Tinkerforge/imu-v2-brick/software/examples/labview/Example All Data.vi.png

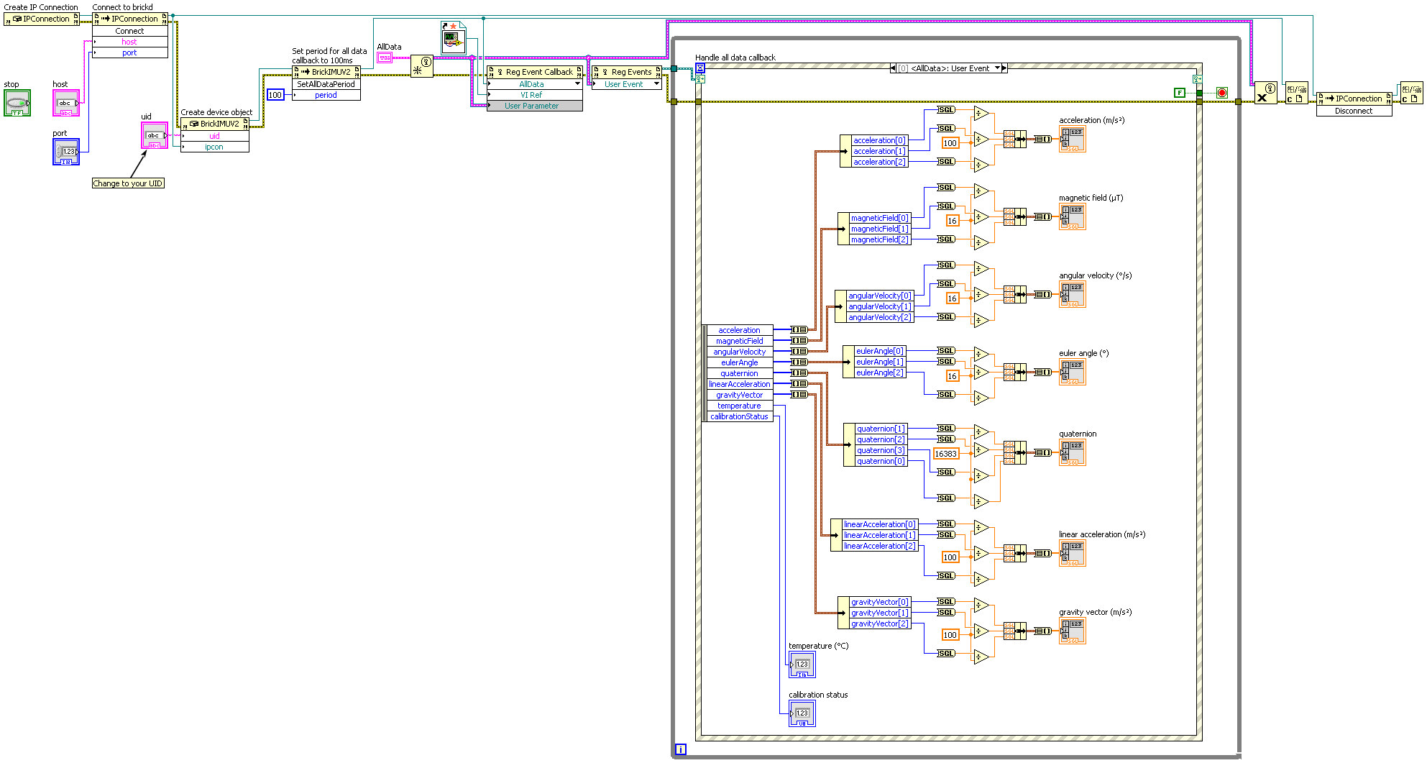
software/examples/labview/Example All Data.vi.png
