Tinkerforge/imu-v2-brick/software/examples/labview/Example Callback.vi.png

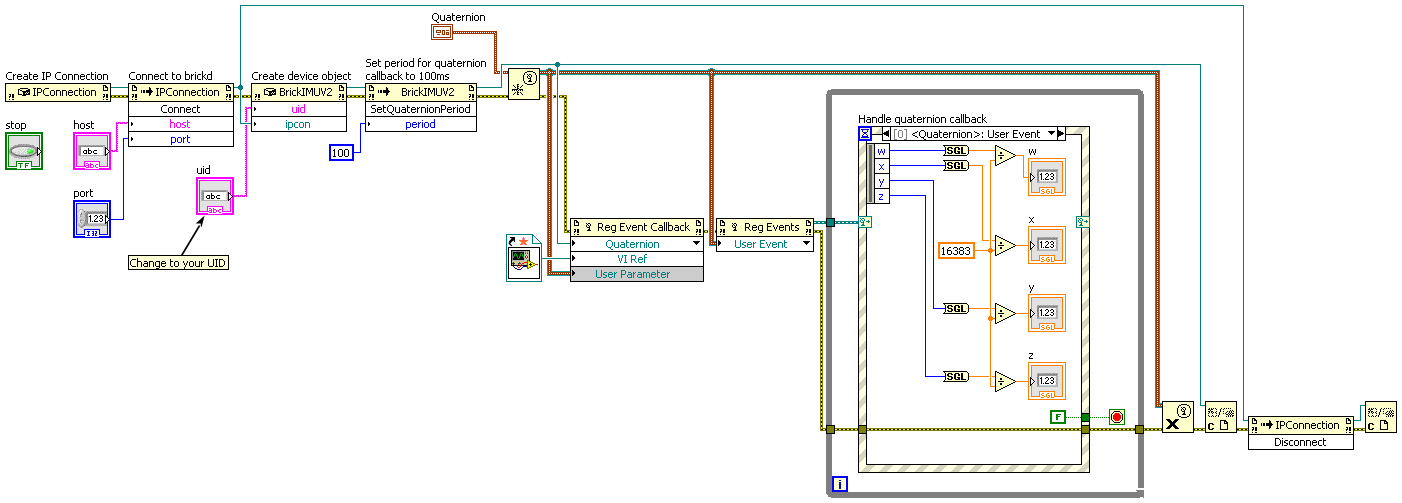
software/examples/labview/Example Callback.vi.png
