Tinkerforge/imu-v2-brick/software/examples/labview/Example Simple.vi.png

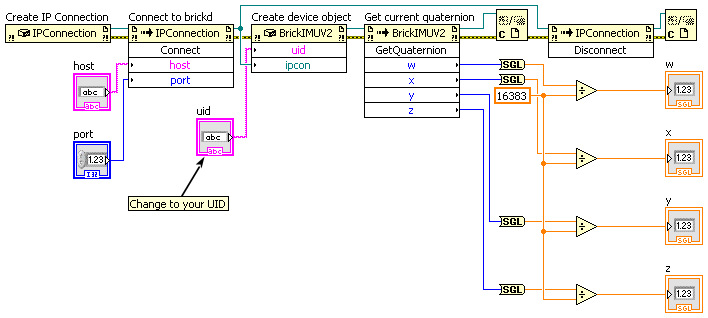
software/examples/labview/Example Simple.vi.png
