Tinkerforge/imu-v2-brick/hardware/imu.FCStd

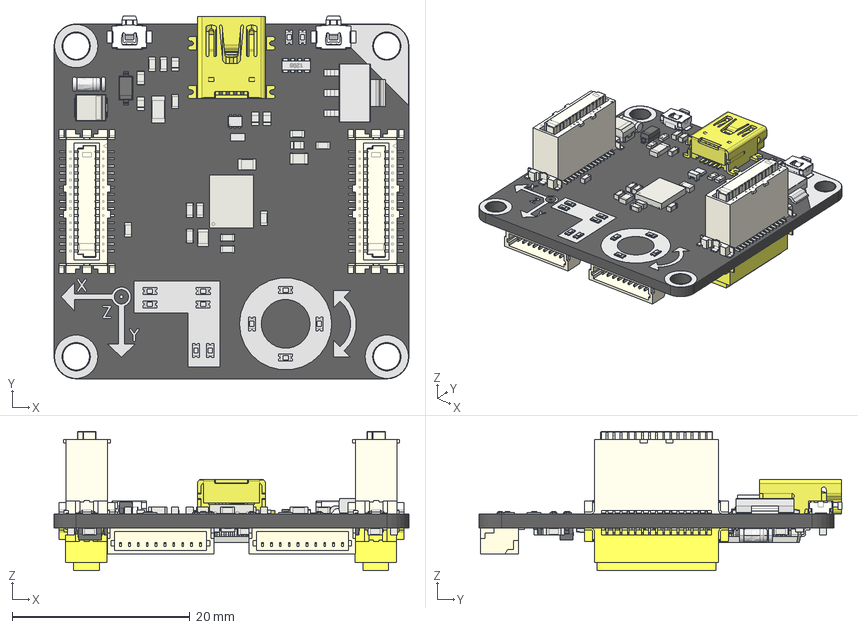
[picture p4: CAD file, 2019-05-15]
hardware/imu.FCStd
40.0 x 40.9 x 15.7 mm
Pcb
silk
USB_
Taster_
Taster_001
dfn8_6x5_p127_
R_0603_
R_0603_005
R_0603_006
R_0603_007
R_0603_008
R_0603_009
C_0805_
C_0603_
C_0603_001
C_0603_005
C_0603_006
C_0603_007
C_1206_
C_0603_013
C_0603_014
C_0805_003
C_0805_004
C_0603_027
C_0603_028
C_0603_029
C_0603_030
C_0603_033
btb_top_
btb_top_001
SOD-123_
Tantalum_B_3528H21_
WE-CNSW-0603_
SOT-563_
MiniMelf_001
SOT-223_
R_4x0603_004
D_0603_blue_
D_0603_blue_001
D_0603_blue_002
D_0603_blue_003
D_0603_blue_004
D_0603_blue_005
D_0603_blue_006
D_0603_blue_007
D_0603_blue_008
D_0603_blue_009
D_0603_red_
D_0603_blue_010
R_0603_001
R_0603_002
R_0603_003
R_0603_004
dfn10_2x3_p05_
dfn10_2x3_p05_001
C_0603_002
C_0603_003
C_0603_004
C_0603_008
C_0603_009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
