Tinkerforge/imu-v2-brick/hardware/imu-schematic.pdf

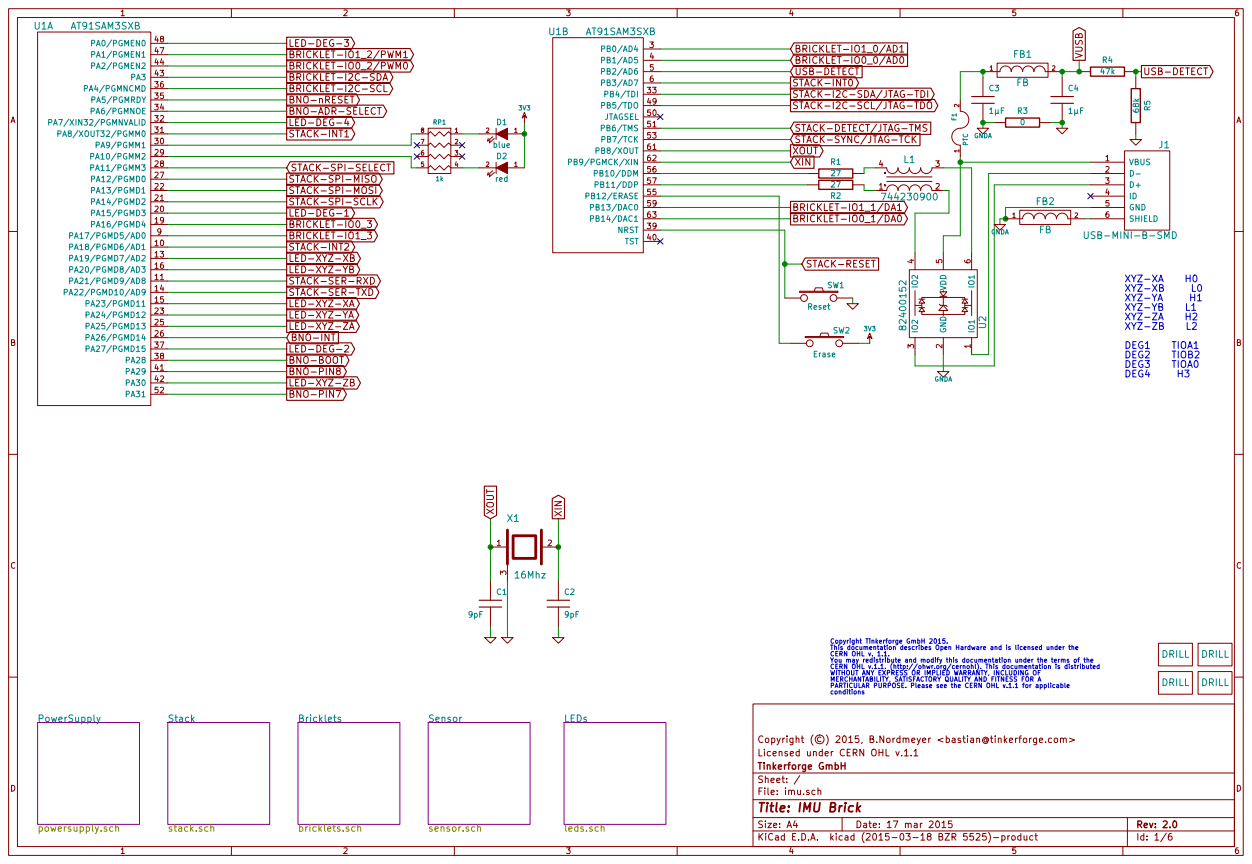
[picture p5: page 1]

BRICKLET-IO0_2/PWM0 Bricklets bricklets.sch
BRICKLET-I2C-SDA
BRICKLET-I2C-SCL
SW1 Reset SW2 Erase BNO-nRESET
3V3 BRICKLET-IO1_3
BNO-ADR-SELECT
1k LED-DEG-4
STACK-INT1

STACK-INT0
STACK-I2C-SDA/JTAG-TDI
STACK-I2C-SCL/JTAG-TDO

STACK-DETECT/JTAG-TMS
STACK-SYNC/JTAG-TCK
XOUT
XIN

Copyright Tinkerforge GmbH 2015. This documentation describes Open Hardware and is licensed under the CERN OHL v. 1.1. You may redistribute and modify this documentation under the terms of the CERN OHL v.1.1. (http://ohwr.org/cernohl). This documentation is distributed WITHOUT ANY EXPRESS OR IMPLIED WARRANTY, INCLUDING OF MERCHANTABILITY, SATISFACTORY QUALITY AND FITNESS FOR A

PARTICULAR PURPOSE. Please see the CERN OHL v.1.1 for applicable

Licensed under CERN OHL v.1.1 Copyright (©) 2015, B.Nordmeyer <bastian@tinkerforge.com>

File: imu.sch Sheet: / Tinkerforge GmbH

Id: 1/6 Title: IMU Brick

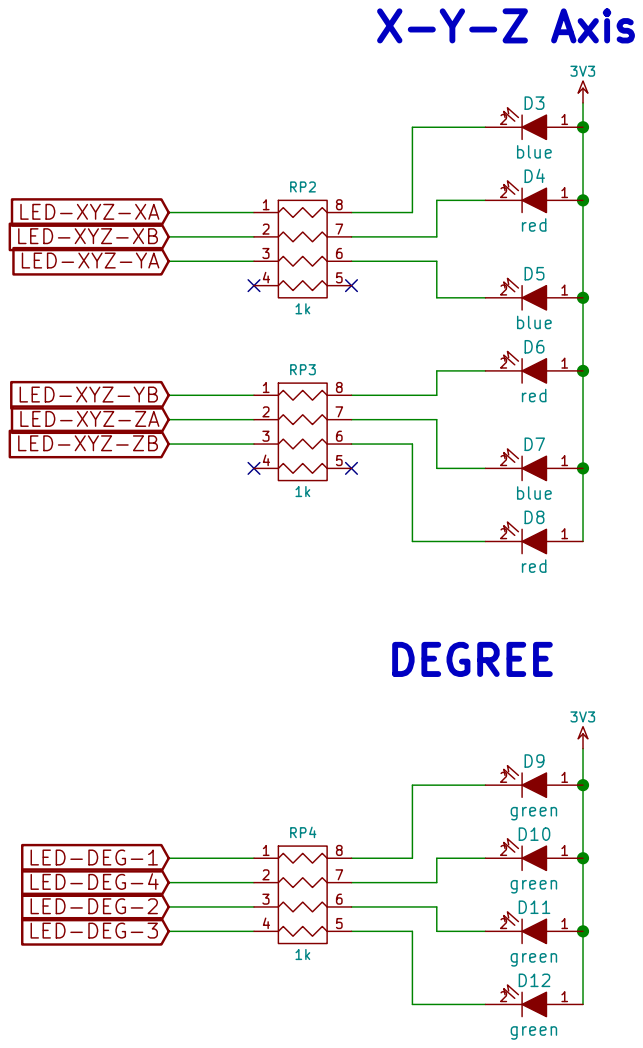
[picture p6: page 2]

Licensed under CERN OHL v.1.1 Copyright (©) 2015, B.Nordmeyer <bastian@tinkerforge.com>

File: leds.sch Sheet: /LEDs/ Tinkerforge GmbH

Id: 2/6 Title: IMU Brick

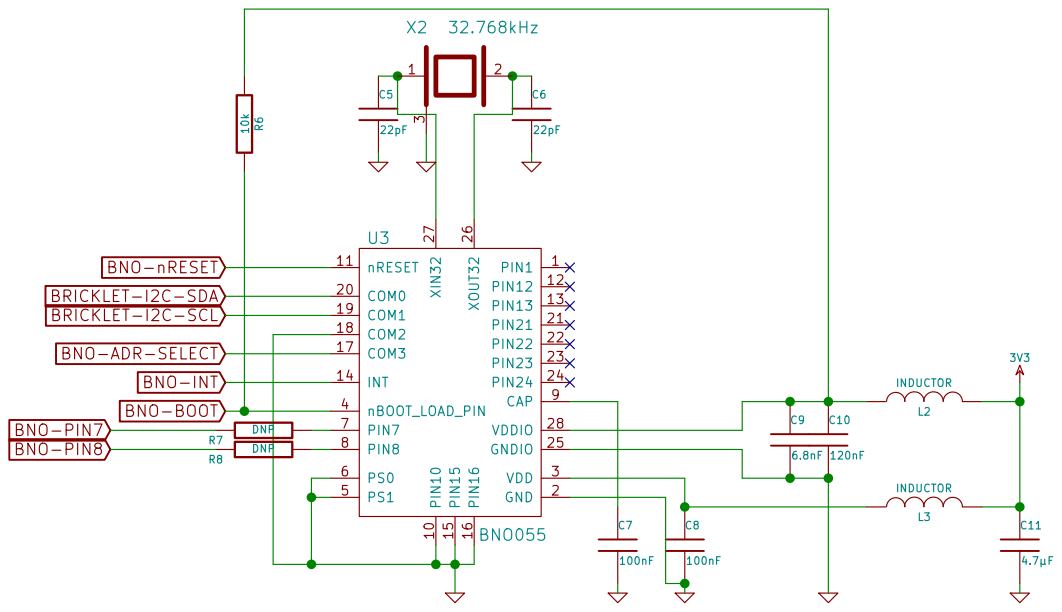
[picture p7: page 3]

Licensed under CERN OHL v.1.1 Copyright (©) 2015, B.Nordmeyer <bastian@tinkerforge.com>

File: sensor.sch Sheet: /Sensor/ Tinkerforge GmbH

Id: 3/6 Title: IMU Brick

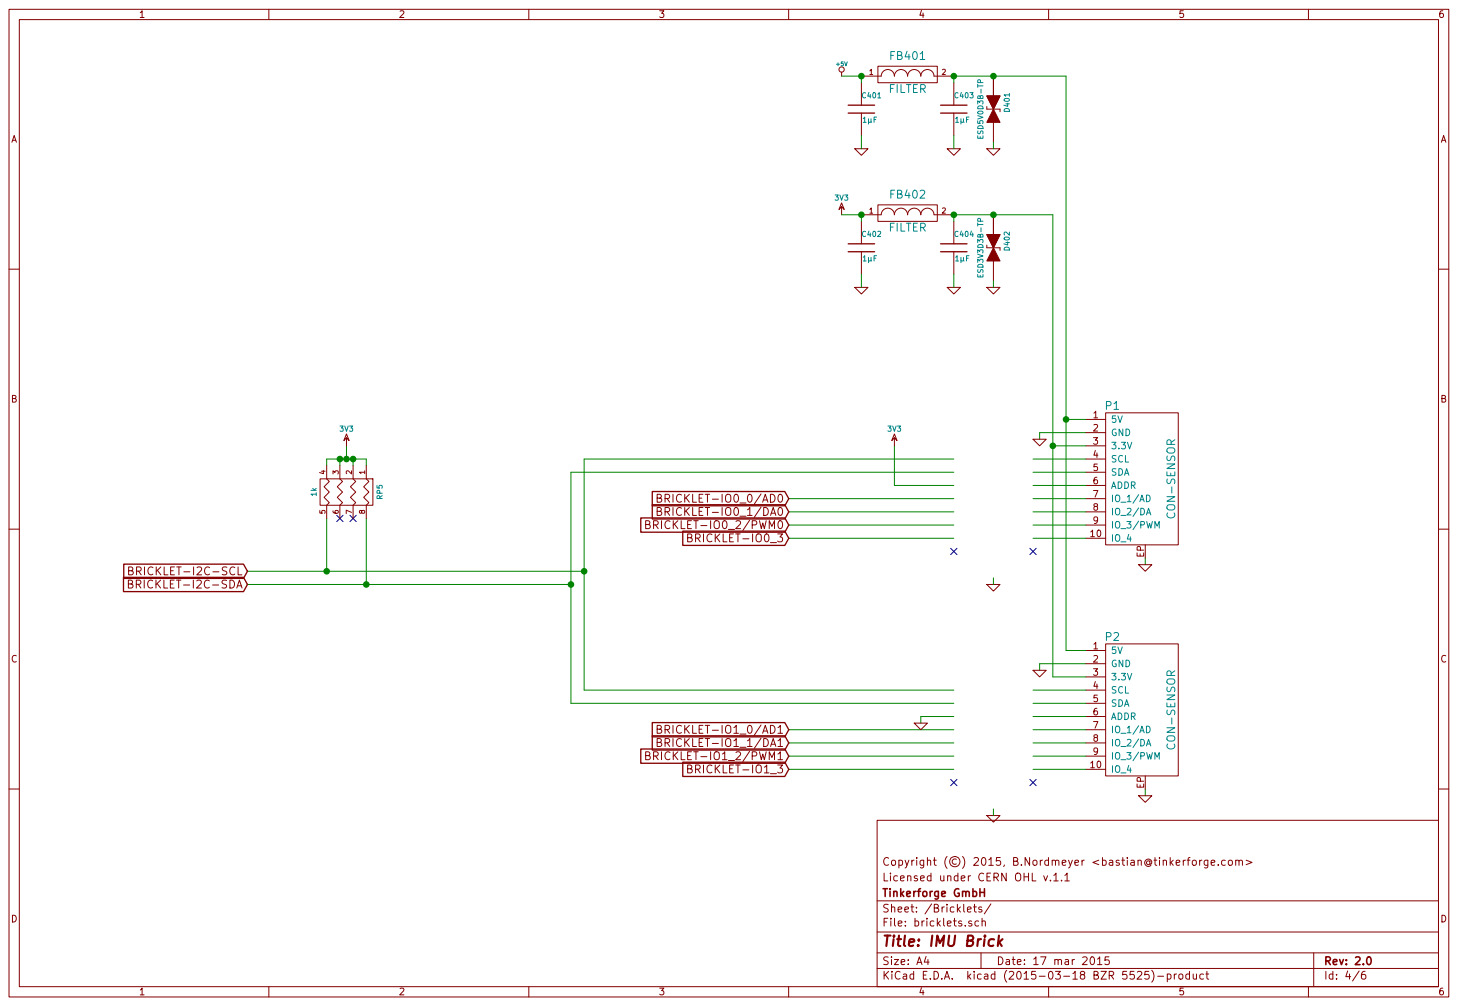
[picture p8: page 4]

IO_3/PWM 9

File: bricklets.sch Sheet: /Bricklets/ Tinkerforge GmbH

Id: 4/6 Title: IMU Brick

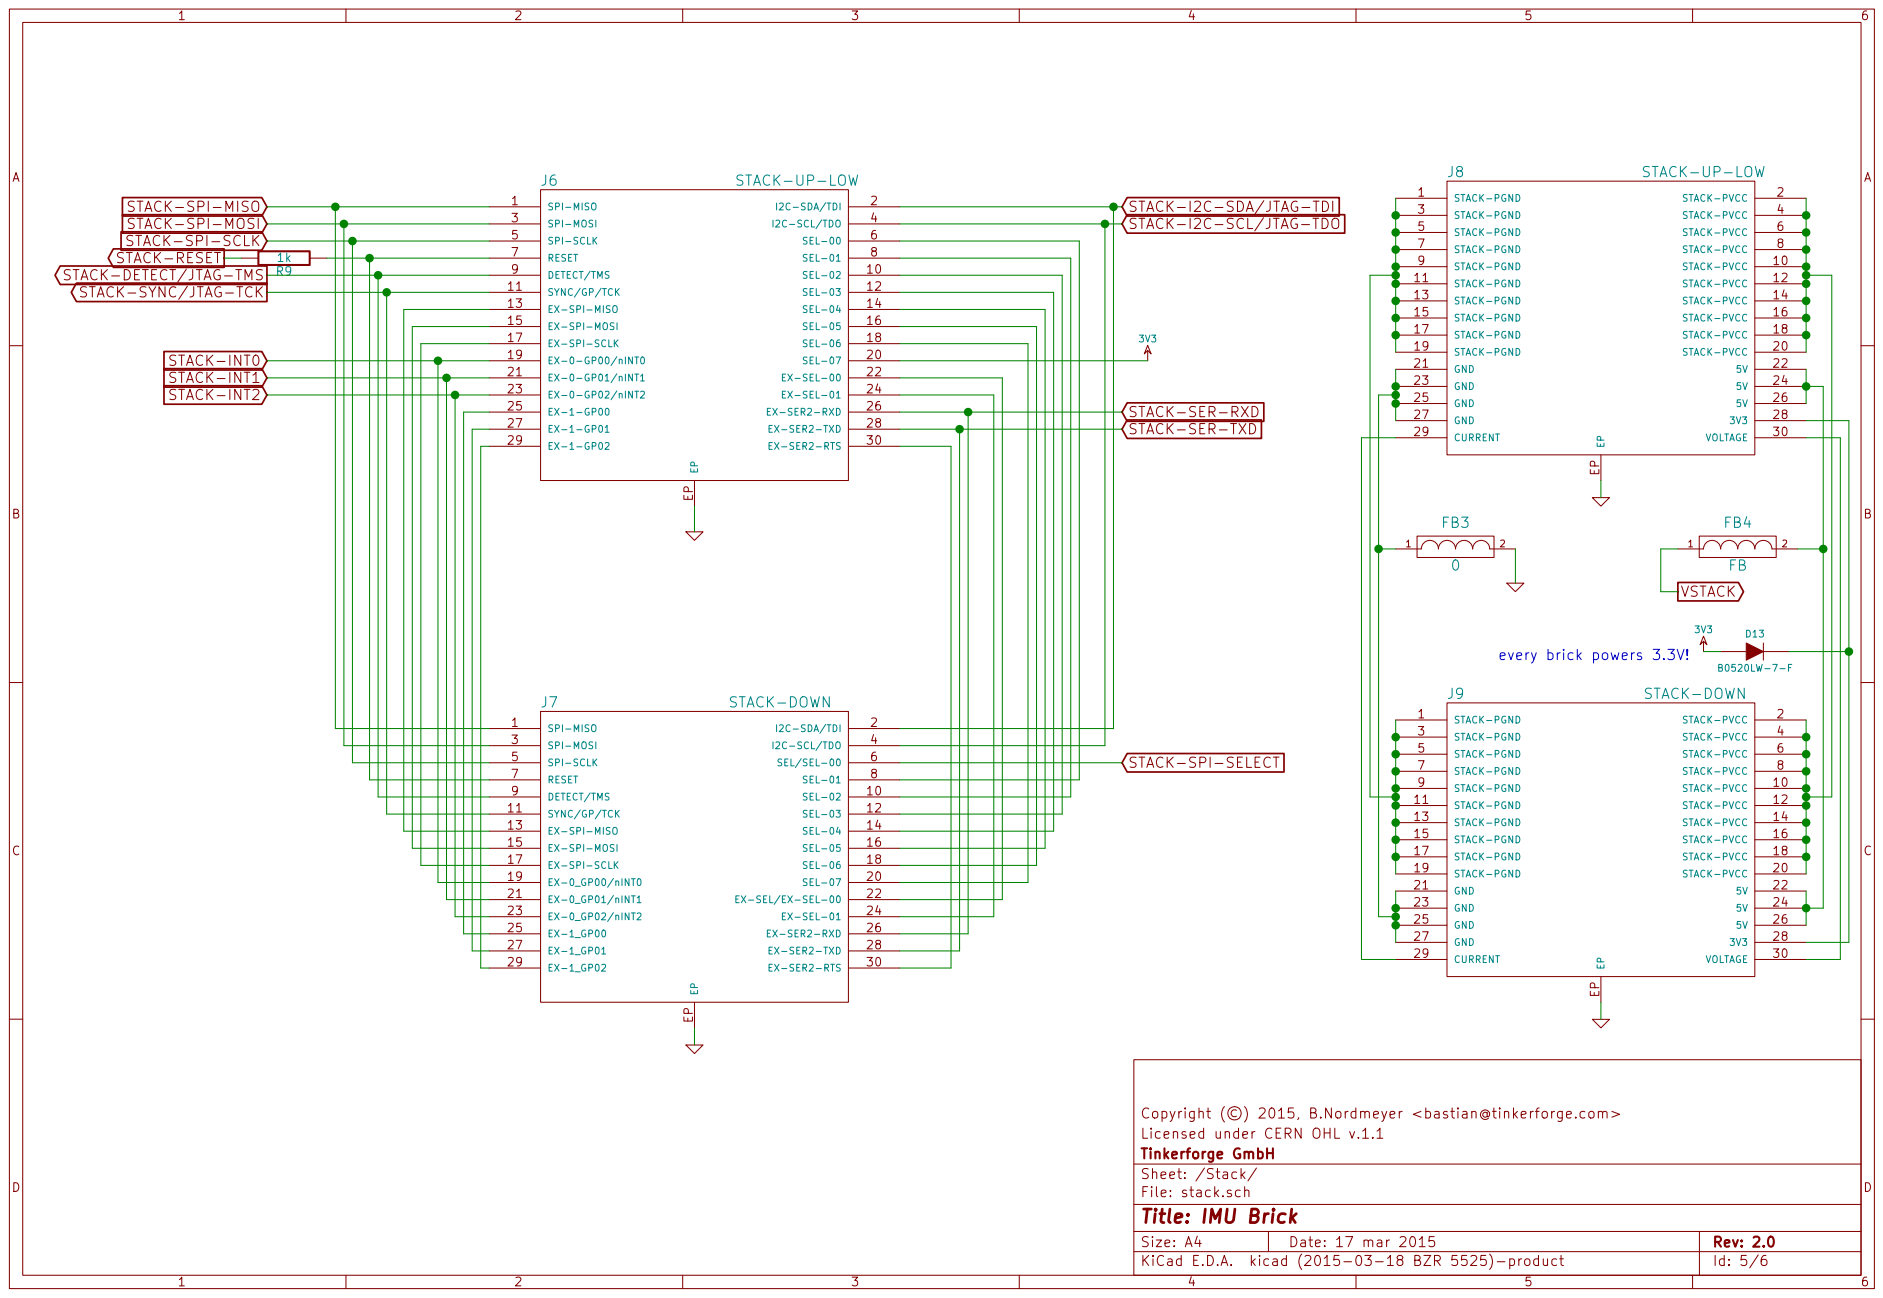
[picture p9: page 5]

STACK-SPI-MISO
STACK-SPI-MOSI
STACK-SPI-SCLK
STACK-RESET
STACK-DETECT/JTAG-TMS
STACK-SYNC/JTAG-TCK

STACK-I2C-SDA/JTAG-TDI
STACK-I2C-SCL/JTAG-TDO

Licensed under CERN OHL v.1.1 Copyright (©) 2015, B.Nordmeyer <bastian@tinkerforge.com>

File: stack.sch Sheet: /Stack/ Tinkerforge GmbH

Id: 5/6 Title: IMU Brick

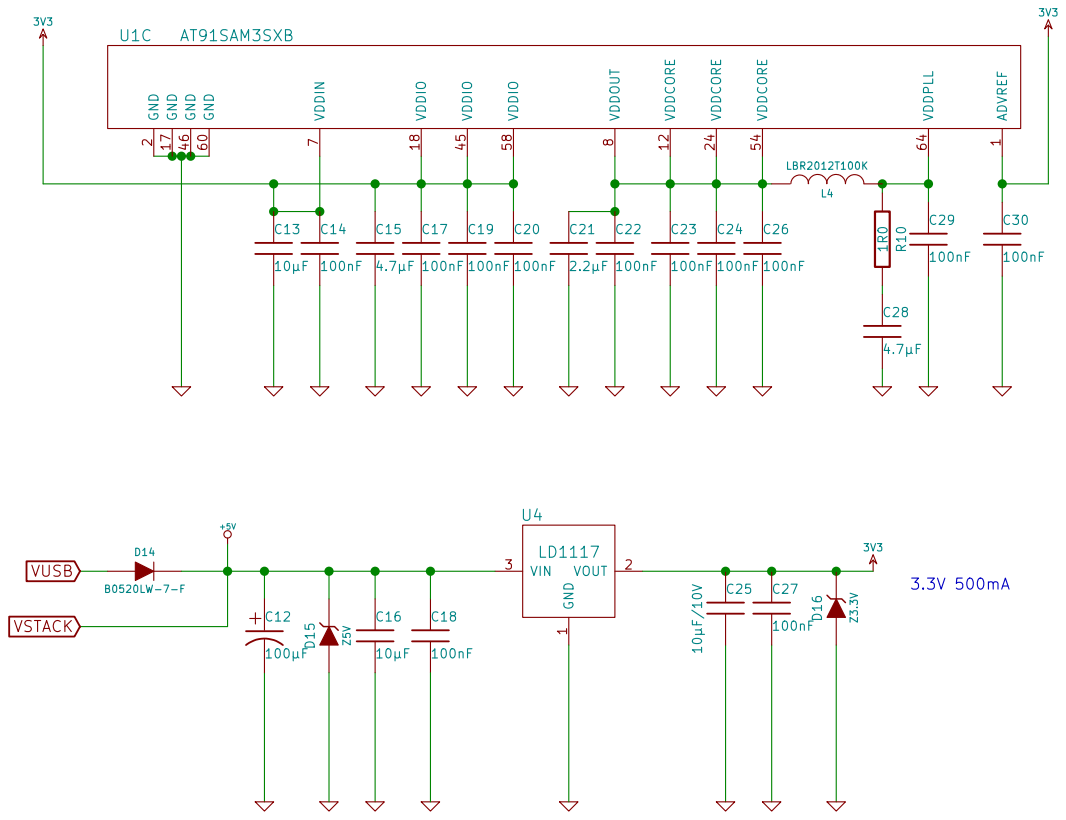
[picture p10: page 6]

8 GND 60 VDDCORE 12 VDDCORE 24 VDDCORE 54 VDDPLL 64 VDDIO 45 GND 46 GND 17 VDDIO 18 VDDIO 58

Licensed under CERN OHL v.1.1 Copyright (©) 2015, B.Nordmeyer <bastian@tinkerforge.com>

Tinkerforge GmbH
Sheet: /PowerSupply/
File: powersupply.sch
Id: 6/6 Title: IMU Brick
