Tinkerforge/imu-v2-brick/hardware/imu.kicad_pcb

## KiCad design hardware/imu.kicad_pcb (2023-05-02)

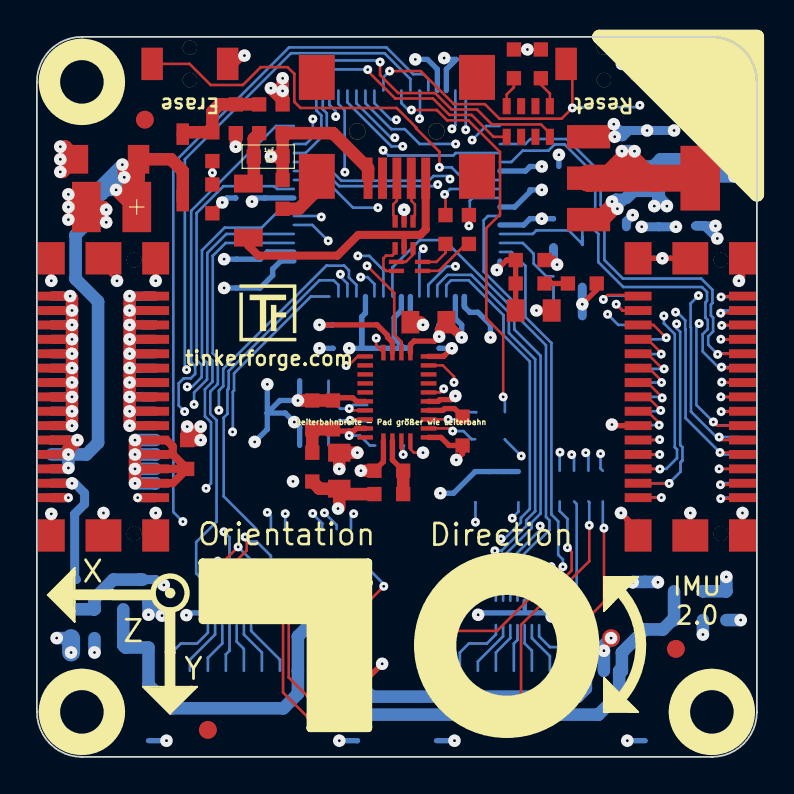
[picture p11: board imu.kicad_pcb from above]

Board: 4 copper layers, 40.0 x 40.0 mm, 107 parts (0 on the bottom side), 124 nets.

Parts:
C1, C2: DNP; C0603
C3: 1µF; 0603
C4, C401, C402, C403, C404: 1µF; C0603
C5, C6: 22pF; C0603
C7, C8, C14, C17, C18, C19, C20, C22, C23, C24, C26, C27, C29, C30: 100nF; C0603
C9: 6.8nF; C0603
C10: 120nF; C0603
C11: 4.7µF; C0805
C12: 100µF; 3528-21
C13, C16: 10µF; C0805
C15, C28: 4.7µF; C0603
C21: 2.2µF; C0603
C25: 10µF/10V; C0805
D1, D3, D5, D7: blue; D0603
D2, D4, D6, D8: red; D0603
D9, D10, D11, D12: green; D0603
D13, D14: B0520LW-7-F; SOD-123
D15: Z5V; MiniMelf
D16: Z3.3V; MiniMelf
D401: ESD5V0D3B-TP; SOD-323
D402: ESD3V3D3B-TP; SOD-323
F1: PTC; C1206
FB1, FB2, FB4: FB; C0603
FB3: 0; C0603
FB401, FB402: FILTER; C0603
FILTER401, FILTER402: IP4254; DFN16-33x135
Fiducial_Mark: VAL**; Fiducial_Mark
Fiducial_Mark#2, Fiducial_Mark#3, Fiducial_Mark#4, Fiducial_Mark#5, Fiducial_Mark#6: VAL**; Fiducial_Mark
J1: USB-MINI-B-SMD
J2, J3, J4, J5: DRILL; DRILL_NP
J6, J8: STACK-UP-LOW; BTB08-ACS-TOP
J7, J9: STACK-DOWN; BTB08-ACS-BTM
L1: 744230900; WE-CNSW-0603
L2, L3: INDUCTOR; C0603
L4: LBR2012T100K; C0805
P1, P2: CON-SENSOR
R1, R2: 27; R0603
R3: 0; R0603
R4: 47k; R0603
R5: 68k; R0603
R6: 10k; R0603
R7, R8: DNP; R0603
R9: 1k; R0603
R10: 1R0; R0603
RP1, RP2, RP3, RP4, RP5: 1k; 0603X4
SW1: Reset; TACT-SWITCH
SW2: Erase; TACT-SWITCH
U1: AT91SAM3SXB; LQFP64
U2: 82400152; SOT563-SPEC
U3: BNO055; LGA28_5832
U4: LD1117; SOT-223
VAL: CE_5mm
VAL#2: WEEE_7mm
X1: 16Mhz; CRYSTAL_3225
X2: 32.768kHz; AB26TRQ

Connections:
3V3: C11.1, C13.1, C14.1, C15.1, C17.1, C19.1, C20.1, C25.1, C27.1, C30.1, C402.1, D1.1, D2.1, D3.1, D4.1, D5.1, D6.1, D7.1, D8.1, D9.1, D10.1, D11.1, D12.1, D13.1, D16.2, FB402.1, FILTER401.14, J6.20, L2.2, L3.2, RP5.1, RP5.2, RP5.3, RP5.4, SW2.2, U1.1, U1.7, U1.18, U1.45, U1.58, U4.2
BNO-ADR-SELECT: U1.34, U3.17
BNO-BOOT: R6.2, U1.38, U3.4
BNO-INT: U1.26, U3.14
BNO-PIN7: R7.1, U1.52
BNO-PIN8: R8.1, U1.41
BNO-nRESET: U1.35, U3.11
BRICKLET-I2C-SCL: FILTER401.16, FILTER402.16, RP5.5, U1.36, U3.19
BRICKLET-I2C-SDA: FILTER401.15, FILTER402.15, RP5.8, U1.43, U3.20
BRICKLET-IO0_0/AD0: FILTER401.13, U1.4
BRICKLET-IO0_1/DA0: FILTER401.12, U1.63
BRICKLET-IO0_2/PWM0: FILTER401.11, U1.44
BRICKLET-IO0_3: FILTER401.10, U1.19
BRICKLET-IO1_0/AD1: FILTER402.13, U1.3
BRICKLET-IO1_1/DA1: FILTER402.12, U1.59
BRICKLET-IO1_2/PWM1: FILTER402.11, U1.47
BRICKLET-IO1_3: FILTER402.10, U1.9
GND: C1.2, C2.2, C4.2, C5.2, C6.2, C7.2, C8.2, C9.2, C10.2, C11.2, C12.2, C13.2, C14.2, C15.2, C16.2, C17.2, C18.2, C19.2, C20.2, C21.2, C22.2, C23.2, C24.2, C25.2, C26.2, C27.2, C28.2, C29.2, C30.2, C401.2, C402.2, C403.2, C404.2, D15.1, D16.1, D401.1, D402.1, FB3.2, FILTER401.EXP, FILTER402.14, FILTER402.EXP, J6.EP, J7.EP, J8.EP, J9.EP, P1.2, P1.EP, P2.2, P2.EP, R3.1, R5.1, SW1.2, U1.2, U1.17, U1.46, U1.60, U3.2, U3.5, U3.6, U3.10, U3.15, U3.16, U3.18, U3.25, U4.1, X1.3, X2.3
GNDA: C3.2, FB2.1, J1.5, R3.2, U2.2
LED-DEG-1: RP4.1, U1.20
LED-DEG-2: RP4.3, U1.37
LED-DEG-3: RP4.4, U1.48
LED-DEG-4: RP4.2, U1.32
LED-XYZ-XA: RP2.1, U1.15
LED-XYZ-XB: RP2.2, U1.13
LED-XYZ-YA: RP2.3, U1.23
LED-XYZ-YB: RP3.1, U1.16
LED-XYZ-ZA: RP3.2, U1.25
LED-XYZ-ZB: RP3.3, U1.42
unnamed: C3.1, F1.2, FB1.1
unnamed: C5.1, U3.27, X2.2
unnamed: C6.1, U3.26, X2.1
unnamed: C7.1, U3.9
unnamed: C8.1, L3.1, U3.3
unnamed: C9.1, C10.1, L2.1, R6.1, U3.28
unnamed: C21.1, C22.1, C23.1, C24.1, C26.1, L4.1, U1.8, U1.12, U1.24, U1.54
unnamed: C28.1, R10.1
unnamed: C29.1, L4.2, R10.2, U1.64
unnamed: C403.1, D401.2, FB401.2, P1.1, P2.1
unnamed: C404.1, D402.2, FB402.2, P1.3, P2.3
unnamed: D1.2, RP1.1
unnamed: D2.2, RP1.4
unnamed: D3.2, RP2.8
unnamed: D4.2, RP2.7
unnamed: D5.2, RP2.6
unnamed: D6.2, RP3.8
unnamed: D7.2, RP3.7
unnamed: D8.2, RP3.6
unnamed: D9.2, RP4.8
unnamed: D10.2, RP4.7
unnamed: D11.2, RP4.6
unnamed: D12.2, RP4.5
unnamed: D13.2, J8.28, J9.28
unnamed: F1.1, J1.1, U2.5
unnamed: FB2.2, J1.6
unnamed: FB3.1, J8.21, J8.23, J8.25, J8.27, J9.21, J9.23, J9.25, J9.27
unnamed: FB4.2, J8.22, J8.24, J8.26, J9.22, J9.24, J9.26
unnamed: FILTER401.1, P1.4
unnamed: FILTER401.2, P1.5
unnamed: FILTER401.3, P1.6
unnamed: FILTER401.4, P1.7
unnamed: FILTER401.5, P1.8
unnamed: FILTER401.6, P1.9
unnamed: FILTER401.7, P1.10
unnamed: FILTER402.1, P2.4
unnamed: FILTER402.2, P2.5
unnamed: FILTER402.3, P2.6
unnamed: FILTER402.4, P2.7
unnamed: FILTER402.5, P2.8
unnamed: FILTER402.6, P2.9
unnamed: FILTER402.7, P2.10
unnamed: J1.2, U2.1
unnamed: J1.3, U2.3
unnamed: J6.6, J7.8
unnamed: J6.7, J7.7, R9.1
unnamed: J6.8, J7.10
unnamed: J6.10, J7.12
unnamed: J6.12, J7.14
unnamed: J6.13, J7.13
unnamed: J6.14, J7.16
unnamed: J6.15, J7.15
unnamed: J6.16, J7.18
unnamed: J6.17, J7.17
unnamed: J6.18, J7.20
unnamed: J6.22, J7.22
unnamed: J6.24, J7.24
unnamed: J6.25, J7.25
unnamed: J6.27, J7.27
unnamed: J6.29, J7.29
unnamed: J6.30, J7.30
unnamed: J8.1, J8.3, J8.5, J8.7, J8.9, J8.11, J8.13, J8.15, J8.17, J8.19, J9.1, J9.3, J9.5, J9.7, J9.9, J9.11, J9.13, J9.15, J9.17, J9.19
unnamed: J8.2, J8.4, J8.6, J8.8, J8.10, J8.12, J8.14, J8.16, J8.18, J8.20, J9.2, J9.4, J9.6, J9.8, J9.10, J9.12, J9.14, J9.16, J9.18, J9.20
unnamed: J8.29, J9.29
unnamed: J8.30, J9.30
unnamed: L1.1, R2.1
unnamed: L1.2, U2.4
unnamed: L1.3, U2.6
unnamed: L1.4, R1.1
unnamed: R1.2, U1.56
unnamed: R2.2, U1.57
unnamed: R7.2, U3.7
unnamed: R8.2, U3.8
unnamed: RP1.5, U1.29
unnamed: RP1.8, U1.30
unnamed: SW2.1, U1.55
STACK-DETECT/JTAG-TMS: J6.9, J7.9, U1.51
STACK-I2C-SCL/JTAG-TDO: J6.4, J7.4, U1.49
STACK-I2C-SDA/JTAG-TDI: J6.2, J7.2, U1.33
STACK-INT0: J6.19, J7.19, U1.6
STACK-INT1: J6.21, J7.21, U1.31
STACK-INT2: J6.23, J7.23, U1.10
STACK-RESET: R9.2, SW1.1, U1.39
STACK-SER-RXD: J6.26, J7.26, U1.11
STACK-SER-TXD: J6.28, J7.28, U1.14
STACK-SPI-MISO: J6.1, J7.1, U1.27
STACK-SPI-MOSI: J6.3, J7.3, U1.22
STACK-SPI-SCLK: J6.5, J7.5, U1.21
STACK-SPI-SELECT: J7.6, U1.28
STACK-SYNC/JTAG-TCK: J6.11, J7.11, U1.53
USB-DETECT: R4.1, R5.2, U1.5
VSTACK: C12.1, C16.1, C18.1, C401.1, D14.2, D15.2, FB4.1, FB401.1, U4.3
VUSB: C4.1, D14.1, FB1.2, R4.2
XIN: C2.1, U1.62, X1.2
XOUT: C1.1, U1.61, X1.1
