Tinkerforge/imu-v2-brick/software/src/main.c

/* imu-v2-brick
 * Copyright (C) 2015 Olaf Lüke <olaf@tinkerforge.com>
 *
 * main.c: IMU Brick 2.0 startup code
 *
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
 * You should have received a copy of the GNU Lesser General Public
 * License along with this library; if not, write to the
 * Free Software Foundation, Inc., 59 Temple Place - Suite 330,
 * Boston, MA 02111-1307, USA.
 */

#include <stdbool.h>
#include <stdint.h>
#include <stdio.h>
#include <stdlib.h>

#include "bricklib/free_rtos/include/FreeRTOS.h"
#include "bricklib/free_rtos/include/task.h"

#include "bricklib/com/i2c/i2c_pca9549/i2c_pca9549.h"
#include "bricklib/com/spi/spi_stack/spi_stack_master.h"
#include "bricklib/com/spi/spi_stack/spi_stack_slave.h"
#include "bricklib/com/spi/spi_stack/spi_stack_common.h"
#include "bricklib/com/i2c/i2c_eeprom/i2c_eeprom_master.h"
#include "bricklib/com/i2c/i2c_eeprom/i2c_eeprom_slave.h"
#include "bricklib/com/usb/usb.h"
#include "bricklib/logging/logging.h"
#include "bricklib/bricklet/bricklet_init.h"
#include "bricklib/drivers/uid/uid.h"
#include "bricklib/drivers/wdt/wdt.h"
#include "bricklib/drivers/pio/pio.h"
#include "bricklib/utility/init.h"
#include "bricklib/utility/util_definitions.h"
#include "bricklib/utility/profiling.h"
#include "bricklib/utility/led.h"
#include "bricklib/logging/logging.h"

#include "config.h"
#include "communication.h"
#include "imu.h"

extern bool usb_first_connection;
uint8_t brick_hardware_version[3];

void vApplicationStackOverflowHook(xTaskHandle *pxTask, signed char *pcTaskName) {
	logf("Stack Overflow: %s\n\r", pcTaskName);
	led_on(LED_STD_RED);
	while(true);
}

int main() {
	imu_leds_on(false);

	const Pin pins_stack[] = {PINS_STACK};
	PIO_Configure(pins_stack, PIO_LISTSIZE(pins_stack));

	brick_hardware_version[0] = BRICK_HARDWARE_VERSION_MAJOR;
	brick_hardware_version[1] = BRICK_HARDWARE_VERSION_MINOR;
	brick_hardware_version[2] = BRICK_HARDWARE_VERSION_REVISION;

	brick_init();
	wdt_restart();

#ifdef PROFILING
    profiling_init();
#endif

    if(usb_is_connected()) {
    	logi("Configure as USB device\n\r");
    	usb_init();
    	wdt_restart();

    	xTaskCreate(usb_message_loop,
    				(signed char *)"usb_ml",
    				700,
    				NULL,
    				1,
    				(xTaskHandle *)NULL);
    } else {
    	usb_first_connection = false;
    	logi("Configure as Stack Participant (SPI)\n\r");
        spi_stack_slave_init();
        wdt_restart();

    	xTaskCreate(spi_stack_slave_message_loop,
    			    (signed char *)"spi_ml",
    			    700,
    			    NULL,
    			    1,
    			    (xTaskHandle *)NULL);
    }

	imu_init();
	wdt_restart();

	brick_init_start_tick_task();
	wdt_restart();

	vTaskStartScheduler();
}
