Tinkerforge/imu-v2-brick/software/src/imu.c

/* imu-v2-brick
 * Copyright (C) 2015 Olaf Lüke <olaf@tinkerforge.com>
 *
 * imu.c: Inertial Measurement Unit implementation
 *
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
 * You should have received a copy of the GNU Lesser General Public
 * License along with this library; if not, write to the
 * Free Software Foundation, Inc., 59 Temple Place - Suite 330,
 * Boston, MA 02111-1307, USA.
 */

#include "imu.h"

#include "config.h"
#include "communication.h"
#include "bricklib/com/com_messages.h"
#include "bricklib/com/com_common.h"
#include "bricklib/logging/logging.h"

#include "bricklib/drivers/pio/pio.h"
#include "bricklib/drivers/twi/twi.h"
#include "bricklib/drivers/twi/twid.h"
#include "bricklib/drivers/async/async.h"
#include "bricklib/drivers/pwmc/pwmc.h"
#include "bricklib/drivers/tc/tc.h"
#include "bricklib/drivers/adc/adc.h"
#include "bricklib/drivers/usb/USBD_HAL.h"
#include "bricklib/utility/util_definitions.h"
#include "bricklib/utility/init.h"
#include "bricklib/utility/led.h"
#include "bricklib/utility/sqrt.h"
#include "bricklib/utility/mutex.h"
#include "bricklib/drivers/flash/flashd.h"
#include "bricklib/drivers/efc/efc.h"

#include <stdio.h>
#include <string.h>
#include <math.h>

uint32_t imu_period[IMU_PERIOD_NUM] = {0};
uint32_t imu_period_counter[IMU_PERIOD_NUM] = {0};

bool imu_use_leds = false;
bool imu_use_orientation = true;
bool imu_mode_update = true;
bool imu_waiting_for_dma = false;
bool imu_mutex_taken = false;
uint8_t imu_waiting_for_dma_counter = 0;

Async imu_async;
extern Twid twid0;
extern Mutex mutex_twi_bricklet;

extern ComInfo com_info;

Pin pins_imu_led[] = {PINS_IMU_LED};
int8_t pins_led_tc_channel[] = {-1, -1, -1, -1, -1, -1, 1, 2, 0, -1};
int8_t pins_led_pwm_channel[] = {0, 0, 1, 1, 2, 2, -1, -1, -1, 3};
bool pins_led_is_pwm[] = {true,
                          true,
                          true,
                          true,
                          true,
                          true,
                          false,
                          false,
                          false,
                          true};

uint8_t sensor_data_tmp[sizeof(uint16_t)*4]; // Maximum size of data read in one piece is sizeof(uint16_t)*4
SensorData sensor_data = {0};
uint8_t update_sensor_counter = 0;


uint8_t imu_magnetometer_rate       = IMU_MAGNETOMETER_RATE_20HZ;
uint8_t imu_gyroscope_range         = IMU_GYROSCOPE_RANGE_2000DPS;
uint8_t imu_gyroscope_bandwidth     = IMU_GYROSCOPE_BANDWIDTH_32HZ;
uint8_t imu_accelerometer_range     = IMU_ACCELEROMETER_RANGE_4G;
uint8_t imu_accelerometer_bandwidth = IMU_ACCELEROMETER_BANDWIDTH_62_5HZ;
uint8_t imu_sensor_fusion_mode      = IMU_SENSOR_FUSION_ON;
uint8_t imu_update                  = 0;

uint32_t cal_counter = 0;

const IMUCalibrationConst *imu_calibration_in_flash = (const IMUCalibrationConst*)IMU_CALIBRATION_ADDRESS;

void tick_task(const uint8_t tick_type) {
	// Check if dma transfer ended in calculation and message task
	// If a bricklet takes the mutex in the calculation task, we can still
	// handle it here in the message task.
	// Unfortunately FreeRTOS does not allow to give the mutex back in the interrupt.
	if(!imu_waiting_for_dma && imu_mutex_taken) {
		// We give the I2C mutex back and we allow a new dma request
		mutex_give(mutex_twi_bricklet);
		imu_mutex_taken = false;

		// Copy data from last DMA transfer before we start a new one
		update_sensor_data_save();
	}

	if(tick_type == TICK_TASK_TYPE_CALCULATION) {
		update_sensor_data();

		if(update_sensor_counter == 5) {
			imu_blinkenlights();
		}

		for(uint8_t i = 0; i < IMU_PERIOD_NUM; i++) {
			if(imu_period_counter[i] < UINT32_MAX) {
				imu_period_counter[i]++;
			}
		}
	} else if(tick_type == TICK_TASK_TYPE_MESSAGE) {
		for(uint8_t i = 0; i < IMU_PERIOD_NUM; i++) {
			if((imu_period[i] != 0) &&
			   (imu_period[i] <= imu_period_counter[i])) {
				// Test if we are totally out of time (lost a whole
				// period), in this case we don't send the callback again.
				// This is needed for the wireless extensions
				if(imu_period[i]*2 <= imu_period_counter[i]) {
					imu_period_counter[i] = imu_period[i];
				}
				make_period_callback(i);
			}
		}
	}
}

void make_period_callback(const uint8_t type) {
	imu_period_counter[type] -= imu_period[type];

	switch(type) {
		case IMU_PERIOD_TYPE_ACC: {
			AccelerationCallback ac;
			com_make_default_header(&ac, com_info.uid, sizeof(AccelerationCallback), FID_ACCELERATION);
			ac.x = sensor_data.acc_x;
			ac.y = sensor_data.acc_y;
			ac.z = sensor_data.acc_z;

			send_blocking_with_timeout(&ac,
			                           sizeof(AccelerationCallback),
			                           com_info.current);
			break;
		}

		case IMU_PERIOD_TYPE_MAG: {
			MagneticFieldCallback mfc;
			com_make_default_header(&mfc, com_info.uid, sizeof(MagneticFieldCallback), FID_MAGNETIC_FIELD);
			mfc.x = sensor_data.mag_x;
			mfc.y = sensor_data.mag_y;
			mfc.z = sensor_data.mag_z;

			send_blocking_with_timeout(&mfc,
			                           sizeof(MagneticFieldCallback),
			                           com_info.current);
			break;
		}

		case IMU_PERIOD_TYPE_ANG: {
			AngularVelocityCallback avc;
			com_make_default_header(&avc, com_info.uid, sizeof(AngularVelocityCallback), FID_ANGULAR_VELOCITY);
			avc.x = sensor_data.gyr_x;
			avc.y = sensor_data.gyr_y;
			avc.z = sensor_data.gyr_z;

			send_blocking_with_timeout(&avc,
			                           sizeof(AngularVelocityCallback),
			                           com_info.current);
			break;
		}

		case IMU_PERIOD_TYPE_TMP: {
			TemperatureCallback tc;
			com_make_default_header(&tc, com_info.uid, sizeof(TemperatureCallback), FID_TEMPERATURE);
			tc.temperature = sensor_data.temperature;

			send_blocking_with_timeout(&tc,
			                           sizeof(TemperatureCallback),
			                           com_info.current);
			break;
		}

		case IMU_PERIOD_TYPE_LIA: {
			LinearAccelerationCallback lac;
			com_make_default_header(&lac, com_info.uid, sizeof(LinearAccelerationCallback), FID_LINEAR_ACCELERATION);
			lac.x = sensor_data.lia_x;
			lac.y = sensor_data.lia_y;
			lac.z = sensor_data.lia_z;

			send_blocking_with_timeout(&lac,
			                           sizeof(LinearAccelerationCallback),
			                           com_info.current);
			break;
		}

		case IMU_PERIOD_TYPE_GRV: {
			GravityVectorCallback gvc;
			com_make_default_header(&gvc, com_info.uid, sizeof(GravityVectorCallback), FID_GRAVITY_VECTOR);
			gvc.x = sensor_data.grv_x;
			gvc.y = sensor_data.grv_y;
			gvc.z = sensor_data.grv_z;

			send_blocking_with_timeout(&gvc,
			                           sizeof(GravityVectorCallback),
			                           com_info.current);
			break;
		}


		case IMU_PERIOD_TYPE_ORI: {
			OrientationCallback oc;
			com_make_default_header(&oc, com_info.uid, sizeof(OrientationCallback), FID_ORIENTATION);
			oc.roll    = sensor_data.eul_roll;
			oc.pitch   = sensor_data.eul_pitch;
			oc.heading = sensor_data.eul_heading;

			send_blocking_with_timeout(&oc,
			                           sizeof(OrientationCallback),
			                           com_info.current);
			break;
		}

		case IMU_PERIOD_TYPE_QUA: {
			QuaternionCallback qc;
			com_make_default_header(&qc, com_info.uid, sizeof(QuaternionCallback), FID_QUATERNION);
			qc.x = sensor_data.qua_x;
			qc.y = sensor_data.qua_y;
			qc.z = sensor_data.qua_z;
			qc.w = sensor_data.qua_w;

			send_blocking_with_timeout(&qc,
			                           sizeof(QuaternionCallback),
			                           com_info.current);
			break;
		}

		case IMU_PERIOD_TYPE_ALL: {
			AllDataCallback adc;
			com_make_default_header(&adc, com_info.uid, sizeof(AllDataCallback), FID_ALL_DATA);

			memcpy(&adc.acceleration, &sensor_data, sizeof(SensorData));

			send_blocking_with_timeout(&adc,
			                           sizeof(AllDataCallback),
			                           com_info.current);
			break;
		}
	}
}

/*
Python script to make the lookup table:

s = "{0"
for i in range(1, 21):
    s += ", " + str(0xffff/2 - ((1000-i**3/((20**3)/1000))*(0xFFFF/2)/1000))
for i in reversed(range(0, 20)):
    s += ", " + str(0xffff/2 + ((1000-i**3/((20**3)/1000))*(0xFFFF/2)/1000))
print s + "}"
*/
const uint16_t blink_lookup[41] = {1, 1, 33, 99, 263, 492, 885, 1377, 2098, 2982, 4096, 5440, 7078, 8979, 11240, 13795, 16777, 20119, 23888, 28082, 32767, 37452, 41646, 45415, 48757, 51739, 54294, 56555, 58456, 60094, 61438, 62552, 63436, 64157, 64649, 65042, 65271, 65435, 65501, 65534, 65534};

void imu_leds_on(const bool on) {
	if(on) {
		PMC->PMC_PCER0 = 1 << ID_PWM;
		for(uint8_t i = 0; i < 4; i++) {
			PWMC_ConfigureChannel(PWM, i, PWM_CMR_CPRE_MCK, 0, 0);
			PWMC_SetPeriod(PWM, i, 0xFFFF);
			PWMC_SetDutyCycle(PWM, i, 0);
			PWMC_EnableChannel(PWM, i);
		}

	    PMC->PMC_PCER0 = 1 << ID_TC0;
	    tc_channel_init(&TC0->TC_CHANNEL[0],
		                TC_CMR_WAVE |
		                TC_CMR_TCCLKS_TIMER_CLOCK1 |
		                TC_CMR_ACPA_CLEAR |
		                TC_CMR_ACPC_SET |
		                TC_CMR_WAVSEL_UP_RC);

	    TC0->TC_CHANNEL[0].TC_RA = 0;
	    TC0->TC_CHANNEL[0].TC_RC = 0xFFFF;
	    tc_channel_start(&TC0->TC_CHANNEL[0]);

	    PMC->PMC_PCER0 = 1 << ID_TC1;
		tc_channel_init(&TC0->TC_CHANNEL[1],
		                TC_CMR_WAVE |
		                TC_CMR_TCCLKS_TIMER_CLOCK1 |
		                TC_CMR_ACPA_CLEAR |
		                TC_CMR_ACPC_SET |
		                TC_CMR_WAVSEL_UP_RC);

	    TC0->TC_CHANNEL[1].TC_RA = 0;
	    TC0->TC_CHANNEL[1].TC_RC = 0xFFFF;
	    tc_channel_start(&TC0->TC_CHANNEL[1]);

	    PMC->PMC_PCER0 = 1 << ID_TC2;
		tc_channel_init(&TC0->TC_CHANNEL[2],
		                TC_CMR_WAVE |
		                TC_CMR_TCCLKS_TIMER_CLOCK1 |
		                TC_CMR_BCPB_CLEAR |
		                TC_CMR_BCPC_SET |
		                TC_CMR_EEVT_XC0 |
		                TC_CMR_WAVSEL_UP_RC);

	    TC0->TC_CHANNEL[2].TC_RB = 0;
	    TC0->TC_CHANNEL[2].TC_RC = 0xFFFF;
	    tc_channel_start(&TC0->TC_CHANNEL[2]);


		PIO_Configure(pins_imu_led, PIO_LISTSIZE(pins_imu_led));
	} else {
		PMC->PMC_PCER0 &= ~(1 << ID_PWM);
		PMC->PMC_PCER0 &= ~(1 << ID_TC0);
		PMC->PMC_PCER0 &= ~(1 << ID_TC1);
		PMC->PMC_PCER0 &= ~(1 << ID_TC2);

		Pin pins[] = {PINS_IMU_LED};
		for(uint8_t i = 0; i < PIO_LISTSIZE(pins); i++) {
			pins[i].type = PIO_OUTPUT_1;
		}

		PIO_Configure(pins, PIO_LISTSIZE(pins));
	}

	imu_use_leds = on;
}

void imu_blinkenlights(void) {
	if(!imu_use_leds) {
		return;
	}

	PWMC_SetDutyCycle(PWM, 0,
	                  blink_lookup[(BETWEEN(-1000, sensor_data.acc_x, 1000) +
	                                1000)/50]);
	PWMC_SetDutyCycle(PWM, 1,
	                  blink_lookup[(BETWEEN(-1000, sensor_data.acc_y, 1000) +
	                                1000)/50]);
	PWMC_SetDutyCycle(PWM, 2,
	                  blink_lookup[40 - (BETWEEN(-1000, sensor_data.acc_z, 1000) +
	                               1000)/50]);

	int16_t degree = sensor_data.eul_heading/16;
	if(degree < 0) {
		degree += 360;
	}

	if(degree < 90) {
		uint8_t index = degree * 40 / 90;
		TC0->TC_CHANNEL[0].TC_RA = blink_lookup[40-index];;
		TC0->TC_CHANNEL[1].TC_RA = 0;
		TC0->TC_CHANNEL[2].TC_RB = 0;
		PWMC_SetDutyCycle(PWM, 3, blink_lookup[40-index]);
	} else if(degree < 180) {
		uint8_t index = (degree - 90) * 40 / 90;
		TC0->TC_CHANNEL[0].TC_RA = blink_lookup[index];
		TC0->TC_CHANNEL[1].TC_RA = blink_lookup[40-index];
		TC0->TC_CHANNEL[2].TC_RB = 0;
		PWMC_SetDutyCycle(PWM, 3, 0);
	} else if(degree < 270) {
		uint8_t index = (degree - 180) * 40 / 90;
		TC0->TC_CHANNEL[0].TC_RA = 0;
		TC0->TC_CHANNEL[1].TC_RA = blink_lookup[index];
		TC0->TC_CHANNEL[2].TC_RB = blink_lookup[40-index];
		PWMC_SetDutyCycle(PWM, 3, 0);
	} else {
		uint8_t index = (degree - 270) * 40 / 90;
		TC0->TC_CHANNEL[0].TC_RA = 0;
		TC0->TC_CHANNEL[1].TC_RA = 0;
		TC0->TC_CHANNEL[2].TC_RB = blink_lookup[index];
		PWMC_SetDutyCycle(PWM, 3, blink_lookup[index]);
	}
}

void update_sensor_data_save(void) {
	// We disable irq during copying of data, otherwise we may get an interrupt
	// right in the middle of the memcpy and the data is corrupted
	__disable_irq();
	switch(update_sensor_counter) {
		case 0:
			memcpy((uint8_t*)&sensor_data.acc_x, sensor_data_tmp, sizeof(int16_t)*3);
			break;
		case 1:
			memcpy((uint8_t*)&sensor_data.mag_x, sensor_data_tmp, sizeof(int16_t)*3);
			break;
		case 2:
			memcpy((uint8_t*)&sensor_data.gyr_x, sensor_data_tmp, sizeof(int16_t)*3);
			break;
		case 3:
			memcpy((uint8_t*)&sensor_data.eul_heading, sensor_data_tmp, sizeof(int16_t)*3);
			break;
		case 4:
			memcpy((uint8_t*)&sensor_data.qua_w, sensor_data_tmp, sizeof(uint16_t)*4);
			break;
		case 5:
			memcpy((uint8_t*)&sensor_data.lia_x, sensor_data_tmp, sizeof(int16_t)*3);
			break;
		case 6:
			memcpy((uint8_t*)&sensor_data.grv_x, sensor_data_tmp, sizeof(int16_t)*3);
			break;
		case 7:
			memcpy((uint8_t*)&sensor_data.temperature, sensor_data_tmp, sizeof(int8_t)*1);
			break;
		case 8:
			memcpy((uint8_t*)&sensor_data.calibration_status, sensor_data_tmp, sizeof(uint8_t)*1);
			break;
		default: // should always be in case of 9
			break;
	}
	__enable_irq();

	update_sensor_counter++;
	switch(imu_sensor_fusion_mode) {
		case IMU_SENSOR_FUSION_OFF: {
			if(update_sensor_counter == 3) {
				update_sensor_counter = 7; // Read temperature after acc, mag and gyr data
			} else if(update_sensor_counter > 3) {
				update_sensor_counter = 0; // Go back to beginning after reading temperature
			}

			break;
		}

		case IMU_SENSOR_FUSION_ON_WO_FST_MAG_CAL: // fall-through
		case IMU_SENSOR_FUSION_ON: {
			if(update_sensor_counter == 9) {
				update_sensor_counter = 0;
			}

			break;
		}

		case IMU_SENSOR_FUSION_ON_WO_MAG: {
			if(update_sensor_counter == 1) {
				update_sensor_counter = 2;
			}
			if(update_sensor_counter == 9) {
				update_sensor_counter = 0;
			}

			break;
		}
	}
}

void update_sensor_data_callback(Async *a) {
	// We give the I2C mutex back and we allow a new dma request
	imu_waiting_for_dma = false;
}

void update_sensor_data(void) {
	if(imu_waiting_for_dma) {
		// The communication should only take approximately 0.5ms, if it takes
		// much longer we have to assume that for some reason the DMA callback
		// did not come.
		imu_waiting_for_dma_counter++;
		if(imu_waiting_for_dma_counter > 15) {
			twid0.pTransfer = NULL;
			imu_waiting_for_dma_counter = 0;
			imu_waiting_for_dma = false;
			imu_mutex_taken = false;
			if(imu_mutex_taken) {
				mutex_give(mutex_twi_bricklet);
			}
		}
		return;
	}

	// Don't try to update configuration if mutex is taken
	if(imu_mutex_taken) {
		return;
	}

	// First we take a look for configuration updates
	if(imu_update != 0) {
		if(imu_update & IMU_UPDATE_SENSOR_CONFIGURATION) {
			imu_update_sensor_configuration();
			imu_update &= ~IMU_UPDATE_SENSOR_CONFIGURATION;
		} else if(imu_update & IMU_UPDATE_SENSOR_FUSION_MODE) {
			imu_update_sensor_fusion_mode();
			imu_update &= ~IMU_UPDATE_SENSOR_FUSION_MODE;
		} else if(imu_update & IMU_UPDATE_SENSOR_CALIBRATION) {
			read_calibration_from_bno055_and_save_to_flash();
			imu_update &= ~IMU_UPDATE_SENSOR_CALIBRATION;
		} else {
			// Unknown update!
			// We delete it to not end up in an endless loop
			imu_update = 0;
		}

		return;
	}

	// Make sure that we can't start two DMA requests at a time
	imu_waiting_for_dma = true;
	imu_waiting_for_dma_counter = 0;

	// Unfortunately there does not seem to be a way to
	// get an interrupt from the BMO055 if new data is ready

	// Since the BMO055 has an update rate of 100Hz we just
	// Read the data every 10ms. This unfortunately means that
	// we may get a maximum delay of 10ms before the user
	// gets the data. MEH.
	switch(update_sensor_counter) {
		case 0:
			bmo_read_registers_dma(REG_ACC_DATA_X_LSB, sensor_data_tmp, sizeof(int16_t)*3, update_sensor_data_callback);
			break;
		case 1:
			bmo_read_registers_dma(REG_MAG_DATA_X_LSB, sensor_data_tmp, sizeof(int16_t)*3, update_sensor_data_callback);
			break;
		case 2:
			bmo_read_registers_dma(REG_GYR_DATA_X_LSB, sensor_data_tmp, sizeof(int16_t)*3, update_sensor_data_callback);
			break;
		case 3:
			bmo_read_registers_dma(REG_EUL_HEADING_LSB, sensor_data_tmp, sizeof(int16_t)*3, update_sensor_data_callback);
			break;
		case 4:
			bmo_read_registers_dma(REG_QUA_DATA_W_LSB, sensor_data_tmp, sizeof(uint16_t)*4, update_sensor_data_callback);
			break;
		case 5:
			bmo_read_registers_dma(REG_LIA_DATA_X_LSB, sensor_data_tmp, sizeof(int16_t)*3, update_sensor_data_callback);
			break;
		case 6:
			bmo_read_registers_dma(REG_GRV_DATA_X_LSB, sensor_data_tmp, sizeof(int16_t)*3, update_sensor_data_callback);
			break;
		case 7:
			bmo_read_registers_dma(REG_TEMP, sensor_data_tmp, sizeof(int8_t)*1, update_sensor_data_callback);
			break;
		case 8:
			bmo_read_registers_dma(REG_CALIB_STAT, sensor_data_tmp, sizeof(uint8_t)*1, update_sensor_data_callback);
			break;
		default: // should always be in case of 9
			return;
	}
}

void bmo_write_register(const uint8_t reg, uint8_t const value) {
	mutex_take(mutex_twi_bricklet, MUTEX_BLOCKING);
	TWID_Write(&twid0,
	           BMO055_ADDRESS_HIGH,
	           reg,
	           1,
	           (uint8_t *)&value,
	           1,
	           NULL);
	mutex_give(mutex_twi_bricklet);
}

void bmo_write_registers(const uint8_t reg, const uint8_t *data, const uint8_t length) {
	mutex_take(mutex_twi_bricklet, MUTEX_BLOCKING);
    TWID_Write(&twid0,
    		   BMO055_ADDRESS_HIGH,
    		   reg,
               1,
               (uint8_t *)data,
               length,
               NULL);
	mutex_give(mutex_twi_bricklet);
}

void bmo_read_registers(const uint8_t reg, uint8_t *data, const uint8_t length) {
	mutex_take(mutex_twi_bricklet, MUTEX_BLOCKING);
    TWID_Read(&twid0,
    		  BMO055_ADDRESS_HIGH,
    		  reg,
              1,
              data,
              length,
              NULL);
	mutex_give(mutex_twi_bricklet);
}

void bmo_read_registers_dma(const uint8_t reg, uint8_t *data, const uint8_t length, void *callback) {
	imu_mutex_taken = true;
	mutex_take(mutex_twi_bricklet, MUTEX_BLOCKING);
	imu_async.callback = callback;

	TWID_Read(&twid0,
	          BMO055_ADDRESS_HIGH,
	          reg,
	          1,
	          data,
	          length,
	          &imu_async);
}

bool read_calibration_from_bno055_and_save_to_flash(void) {
	if(sensor_data.calibration_status != 0xFF) {
		return false;
	}

	bmo_write_register(REG_OPR_MODE, 0b00000000); // Configuration Mode
	SLEEP_MS(19);
	IMUCalibration imu_calibration = {{0}};
	bmo_read_registers(REG_ACC_OFFSET_X_LSB, (uint8_t *)&imu_calibration, IMU_CALIBRATION_LENGTH);
	imu_calibration.password = IMU_CALIBRATION_PASSWORD;
	bmo_write_register(REG_OPR_MODE, 0b00001100); // Enable NDOF, see Table 3-5
	SLEEP_MS(7);

	logimui("Read calibration from BNO055 and save to flash:\n\r");
	logimui(" Mag Offset: %d %d %d\n\r", imu_calibration.mag_offset[0], imu_calibration.mag_offset[1], imu_calibration.mag_offset[2]);
	logimui(" Acc Offset: %d %d %d\n\r", imu_calibration.acc_offset[0], imu_calibration.acc_offset[1], imu_calibration.acc_offset[2]);
	logimui(" Gyr Offset: %d %d %d\n\r", imu_calibration.gyr_offset[0], imu_calibration.gyr_offset[1], imu_calibration.gyr_offset[2]);
	logimui(" Acc Radius: %d\n\r", imu_calibration.acc_radius);
	logimui(" Mag Radius: %d\n\r", imu_calibration.mag_radius);

	DISABLE_RESET_BUTTON();
	__disable_irq();

	// Only change wait states on SAM4, because this makes a SAM3 hang for unknown reasons
	if(!IS_SAM3()) {
		EFC_SetWaitState(EFC, 6);
	}

	// Unlock flash region
	if(FLASHD_Unlock(IMU_CALIBRATION_ADDRESS,
	                 END_OF_BRICKLET_MEMORY,
	                 NULL,
	                 NULL) != 0) {
		return false;
	}

	// On SAM4 we have to erase the flash here, the EFC_FCMD_EWP command does not work...
	if(!IS_SAM3()) {
		// EFC_FCMD_EPA = 0x07
		EFC_PerformCommand(EFC, 0x07, (((256-32)/16) << 4) | 2, 0);
	}

	if(FLASHD_Write(IMU_CALIBRATION_ADDRESS,
	                &imu_calibration,
	                sizeof(IMUCalibration)) != 0) {
		return false;
	}

	if(FLASHD_Lock(IMU_CALIBRATION_ADDRESS,
	               END_OF_BRICKLET_MEMORY,
	               NULL,
			       NULL) != 0) {
		return false;
	}

	if(!IS_SAM3()) {
		EFC_SetWaitState(EFC, 2);
	}

	__enable_irq();
    ENABLE_RESET_BUTTON();

	return true;
}

bool read_calibration_from_flash_and_save_to_bno055(void) {
	bool ret = false;
	if(imu_calibration_in_flash->password == IMU_CALIBRATION_PASSWORD) {
		logimui("Read calibration from flash and save to BNO055:\n\r");
		logimui(" Mag Offset: %d %d %d\n\r", imu_calibration_in_flash->mag_offset[0], imu_calibration_in_flash->mag_offset[1], imu_calibration_in_flash->mag_offset[2]);
		logimui(" Acc Offset: %d %d %d\n\r", imu_calibration_in_flash->acc_offset[0], imu_calibration_in_flash->acc_offset[1], imu_calibration_in_flash->acc_offset[2]);
		logimui(" Gyr Offset: %d %d %d\n\r", imu_calibration_in_flash->gyr_offset[0], imu_calibration_in_flash->gyr_offset[1], imu_calibration_in_flash->gyr_offset[2]);
		logimui(" Acc Radius: %d\n\r", imu_calibration_in_flash->acc_radius);
		logimui(" Mag Radius: %d\n\r", imu_calibration_in_flash->mag_radius);
		ret = true;
		bmo_write_registers(REG_ACC_OFFSET_X_LSB, (uint8_t *)IMU_CALIBRATION_ADDRESS, IMU_CALIBRATION_LENGTH);
	} else {
		logimui("No calibration found\n\r");
	}

	bmo_write_register(REG_OPR_MODE, 0b00001100); // Enable NDOF, see Table 3-5
	SLEEP_MS(7);

	return ret;
}

void imu_startblink(void) {
	imu_leds_on(true);
	Pin pins[] = {PINS_IMU_LED};
	for(uint8_t i = 0; i < 6; i++) {
		pins[i].type = PIO_OUTPUT_1;
	}

	PIO_Configure(pins, PIO_LISTSIZE(pins));

	for(uint8_t i = 0; i < 41; i++) {
		TC0->TC_CHANNEL[0].TC_RA = blink_lookup[i];
		TC0->TC_CHANNEL[1].TC_RA = blink_lookup[i];
		TC0->TC_CHANNEL[2].TC_RB = blink_lookup[i];
		PWMC_SetDutyCycle(PWM, 3, blink_lookup[40-i]);
		SLEEP_MS(6);
	}
	for(uint8_t i = 0; i < 41; i++) {
		TC0->TC_CHANNEL[0].TC_RA = blink_lookup[40-i];
		TC0->TC_CHANNEL[1].TC_RA = blink_lookup[40-i];
		TC0->TC_CHANNEL[2].TC_RB = blink_lookup[40-i];
		PWMC_SetDutyCycle(PWM, 3, blink_lookup[i]);
		SLEEP_MS(6);
	}
	for(uint8_t i = 0; i < 41; i++) {
		TC0->TC_CHANNEL[0].TC_RA = blink_lookup[i];
		TC0->TC_CHANNEL[1].TC_RA = blink_lookup[i];
		TC0->TC_CHANNEL[2].TC_RB = blink_lookup[i];
		PWMC_SetDutyCycle(PWM, 3, blink_lookup[40-i]);
		SLEEP_MS(6);
	}

	imu_leds_on(false);
}

void imu_update_sensor_fusion_mode(void) {
	// First we go to config mode
	bmo_write_register(REG_OPR_MODE, 0b000);
	SLEEP_MS(19);

	// If sensor fusion is turned off, we zero all of the now non-updated data
	switch(imu_sensor_fusion_mode) {
		case IMU_SENSOR_FUSION_OFF: {
			sensor_data.eul_heading        = 0;
			sensor_data.eul_roll           = 0;
			sensor_data.eul_pitch          = 0;
			sensor_data.qua_w              = 0;
			sensor_data.qua_x              = 0;
			sensor_data.qua_y              = 0;
			sensor_data.qua_z              = 0;
			sensor_data.lia_x              = 0;
			sensor_data.lia_y              = 0;
			sensor_data.lia_z              = 0;
			sensor_data.grv_x              = 0;
			sensor_data.grv_y              = 0;
			sensor_data.grv_z              = 0;
			sensor_data.calibration_status = 0;

			bmo_write_register(REG_OPR_MODE, 0b0111);
			break;
		}
		case IMU_SENSOR_FUSION_ON: {
			bmo_write_register(REG_OPR_MODE, 0b1100);
			break;
		}
		case IMU_SENSOR_FUSION_ON_WO_MAG: {
			sensor_data.mag_x              = 0;
			sensor_data.mag_y              = 0;
			sensor_data.mag_z              = 0;

			bmo_write_register(REG_OPR_MODE, 0b1000);
			break;
		}
		case IMU_SENSOR_FUSION_ON_WO_FST_MAG_CAL: {
			bmo_write_register(REG_OPR_MODE, 0b1011);
			break;
		}
	}

	// NDOF if fusion mode on, otherwise AMG
	SLEEP_MS(7);
}

void imu_update_sensor_configuration(void) {
	// First we go to config mode
	bmo_write_register(REG_OPR_MODE, 0b000);
	SLEEP_MS(19);

	// Change page id to 1 to change sensor configurations
	bmo_write_register(REG_PAGE_ID, 1);

	const uint8_t config[4] = {
		((imu_accelerometer_range & 0b11) << 0) | ((imu_accelerometer_bandwidth & 0b111) << 2) | (0b000 << 5), // ACC
		((imu_magnetometer_rate & 0b111) << 0) | (0b01 << 3) | (0b11 << 5),                                    // MAG
		((imu_gyroscope_range & 0b111) << 0) | ((imu_gyroscope_bandwidth & 0b111) << 3),                       // GYR 1
		(0b000 << 0)                                                                                           // GYR 2
	};

	bmo_write_registers(REG_ACC_CONFIG, config, 4);

	// Change page id back
	bmo_write_register(REG_PAGE_ID, 0);

	// NDOF if fusion mode on, otherwise AMG
	bmo_write_register(REG_OPR_MODE, imu_sensor_fusion_mode ? 0b1100 : 0b0111);
	SLEEP_MS(7);
}

void imu_init(void) {
	logimui("IMU init start\n\r");
	Pin pins_bno[] = {PINS_BNO};
	PIO_Configure(pins_bno, PIO_LISTSIZE(pins_bno));

	imu_startblink();

	bmo_write_register(REG_OPR_MODE, 0b00000000); // Configuration Mode
	SLEEP_MS(19);

	bmo_write_register(REG_SYS_TRIGGER, 1 << 7); // Use external clock
	read_calibration_from_flash_and_save_to_bno055();

#ifndef PROFILING
	imu_leds_on(true);
#endif

	logimui("IMU init done\n\r");
}
