Tinkerforge/imu-v2-brick/software/src/imu.h

/* imu-v2-brick
 * Copyright (C) 2015 Olaf Lüke <olaf@tinkerforge.com>
 *
 * imu.h: Inertial Measurement Unit readout implementation
 *
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
 * You should have received a copy of the GNU Lesser General Public
 * License along with this library; if not, write to the
 * Free Software Foundation, Inc., 59 Temple Place - Suite 330,
 * Boston, MA 02111-1307, USA.
 */

#ifndef IMU_H
#define IMU_H

#include <stdint.h>
#include "config.h"

#include "bricklib/drivers/twi/twid.h"

// Sensor configuration constants
#define IMU_UPDATE_SENSOR_CONFIGURATION     (1 << 0)
#define IMU_UPDATE_SENSOR_FUSION_MODE       (1 << 1)
#define IMU_UPDATE_SENSOR_CALIBRATION       (1 << 2)

#define IMU_MAGNETOMETER_RATE_2HZ           0
#define IMU_MAGNETOMETER_RATE_6HZ           1
#define IMU_MAGNETOMETER_RATE_8HZ           2
#define IMU_MAGNETOMETER_RATE_10HZ          3
#define IMU_MAGNETOMETER_RATE_15HZ          4
#define IMU_MAGNETOMETER_RATE_20HZ          5
#define IMU_MAGNETOMETER_RATE_25HZ          6
#define IMU_MAGNETOMETER_RATE_30HZ          7

#define IMU_GYROSCOPE_RANGE_2000DPS         0
#define IMU_GYROSCOPE_RANGE_1000DPS         1
#define IMU_GYROSCOPE_RANGE_500DPS          2
#define IMU_GYROSCOPE_RANGE_250DPS          3
#define IMU_GYROSCOPE_RANGE_125DPS          4

#define IMU_GYROSCOPE_BANDWIDTH_523HZ       0
#define IMU_GYROSCOPE_BANDWIDTH_230HZ       1
#define IMU_GYROSCOPE_BANDWIDTH_116HZ       2
#define IMU_GYROSCOPE_BANDWIDTH_47HZ        3
#define IMU_GYROSCOPE_BANDWIDTH_23HZ        4
#define IMU_GYROSCOPE_BANDWIDTH_12HZ        5
#define IMU_GYROSCOPE_BANDWIDTH_64HZ        6
#define IMU_GYROSCOPE_BANDWIDTH_32HZ        7

#define IMU_ACCELEROMETER_RANGE_2G          0
#define IMU_ACCELEROMETER_RANGE_4G          1
#define IMU_ACCELEROMETER_RANGE_8G          2
#define IMU_ACCELEROMETER_RANGE_16G         3

#define IMU_ACCELEROMETER_BANDWIDTH_7_81HZ  0
#define IMU_ACCELEROMETER_BANDWIDTH_15_63HZ 1
#define IMU_ACCELEROMETER_BANDWIDTH_31_25HZ 2
#define IMU_ACCELEROMETER_BANDWIDTH_62_5HZ  3
#define IMU_ACCELEROMETER_BANDWIDTH_125HZ   4
#define IMU_ACCELEROMETER_BANDWIDTH_250HZ   5
#define IMU_ACCELEROMETER_BANDWIDTH_500HZ   6
#define IMU_ACCELEROMETER_BANDWIDTH_1000HZ  7

#define IMU_SENSOR_FUSION_OFF               0
#define IMU_SENSOR_FUSION_ON                1
#define IMU_SENSOR_FUSION_ON_WO_MAG         2
#define IMU_SENSOR_FUSION_ON_WO_FST_MAG_CAL 3


#define IMU_PERIOD_TYPE_ACC  0
#define IMU_PERIOD_TYPE_MAG  1
#define IMU_PERIOD_TYPE_ANG  2
#define IMU_PERIOD_TYPE_TMP  3
#define IMU_PERIOD_TYPE_LIA  4
#define IMU_PERIOD_TYPE_GRV  5
#define IMU_PERIOD_TYPE_ORI  6
#define IMU_PERIOD_TYPE_QUA  7
#define IMU_PERIOD_TYPE_ALL  8

#define IMU_PERIOD_NUM       9

#define IMU_STARTUP_TIME     650 // see 1.2 (POR time)

#define BMO055_ADDRESS_HIGH  0x29
#define BMO055_ADDRESS_LOW   0x28

#define REG_PAGE_ID          0x07

// Page 0
#define REG_CHIP_ID          0x00
#define REG_ACC_ID           0x01
#define REG_MAG_ID           0x02
#define REG_GYR_ID           0x03
#define REG_SW_REV_ID_LSB    0x04
#define REG_SW_REV_ID_MSB    0x05
#define REG_BL_REV_ID        0x06
#define REG_ACC_DATA_X_LSB   0x08
#define REG_ACC_DATA_X_MSB   0x09
#define REG_ACC_DATA_Y_LSB   0x0A
#define REG_ACC_DATA_Y_MSB   0x0B
#define REG_ACC_DATA_Z_LSB   0x0C
#define REG_ACC_DATA_Z_MSB   0x0D
#define REG_MAG_DATA_X_LSB   0x0E
#define REG_MAG_DATA_X_MSB   0x0F
#define REG_MAG_DATA_Y_LSB   0x10
#define REG_MAG_DATA_Y_MSB   0x11
#define REG_MAG_DATA_Z_LSB   0x12
#define REG_MAG_DATA_Z_MSB   0x13
#define REG_GYR_DATA_X_LSB   0x14
#define REG_GYR_DATA_X_MSB   0x15
#define REG_GYR_DATA_Y_LSB   0x16
#define REG_GYR_DATA_Y_MSB   0x17
#define REG_GYR_DATA_Z_LSB   0x18
#define REG_GYR_DATA_Z_MSB   0x19
#define REG_EUL_HEADING_LSB  0x1A
#define REG_EUL_HEADING_MSB  0x1B
#define REG_EUL_ROLL_LSB     0x1C
#define REG_EUL_ROLL_MSB     0x1D
#define REG_EUL_PITCH_LSB    0x1E
#define REG_EUL_PITCH_MSB    0x1F
#define REG_QUA_DATA_W_LSB   0x20
#define REG_QUA_DATA_W_MSB   0x21
#define REG_QUA_DATA_X_LSB   0x22
#define REG_QUA_DATA_X_MSB   0x23
#define REG_QUA_DATA_Y_LSB   0x24
#define REG_QUA_DATA_Y_MSB   0x25
#define REG_QUA_DATA_Z_LSB   0x26
#define REG_QUA_DATA_Z_MSB   0x27
#define REG_LIA_DATA_X_LSB   0x28
#define REG_LIA_DATA_X_MSB   0x29
#define REG_LIA_DATA_Y_LSB   0x2A
#define REG_LIA_DATA_Y_MSB   0x2B
#define REG_LIA_DATA_Z_LSB   0x2C
#define REG_LIA_DATA_Z_MSB   0x2D
#define REG_GRV_DATA_X_LSB   0x2E
#define REG_GRV_DATA_X_MSB   0x2F
#define REG_GRV_DATA_Y_LSB   0x30
#define REG_GRV_DATA_Y_MSB   0x31
#define REG_GRV_DATA_Z_LSB   0x32
#define REG_GRV_DATA_Z_MSB   0x33
#define REG_TEMP             0x34
#define REG_CALIB_STAT       0x35
#define REG_ST_RESULT        0x36
#define REG_INT_STA          0x37
#define REG_SYS_CLK_STATUS   0x38
#define REG_SYS_STATUS       0x39
#define REG_SYS_ERR          0x3A
#define REG_UNIT_SEL         0x3B
#define REG_OPR_MODE         0x3D
#define REG_PWR_MODE         0x3E
#define REG_SYS_TRIGGER      0x3F
#define REG_TEMP_SOURCE      0x40
#define REG_AXIS_MAP_CONFIG  0x41
#define REG_AXIS_MAP_SIGN    0x42
#define REG_ACC_OFFSET_X_LSB 0x55
#define REG_ACC_OFFSET_X_MSB 0x56
#define REG_ACC_OFFSET_Y_LSB 0x57
#define REG_ACC_OFFSET_Y_MSB 0x58
#define REG_ACC_OFFSET_Z_LSB 0x59
#define REG_ACC_OFFSET_Z_MSB 0x5A
#define REG_MAG_OFFSET_X_LSB 0x5B
#define REG_MAG_OFFSET_X_MSB 0x5C
#define REG_MAG_OFFSET_Y_LSB 0x5D
#define REG_MAG_OFFSET_Y_MSB 0x5E
#define REG_MAG_OFFSET_Z_LSB 0x5F
#define REG_MAG_OFFSET_Z_MSB 0x60
#define REG_GYR_OFFSET_X_LSB 0x61
#define REG_GYR_OFFSET_X_MSB 0x62
#define REG_GYR_OFFSET_Y_LSB 0x63
#define REG_GYR_OFFSET_Y_MSB 0x64
#define REG_GYR_OFFSET_Z_LSB 0x65
#define REG_GYR_OFFSET_Z_MSB 0x66
#define REG_ACC_RADIUS_LSB   0x67
#define REG_ACC_RADIUS_MSB   0x68
#define REG_MAG_RADIUS_LSB   0x69
#define REG_MAG_RADIUS_MSB   0x6A

// Page 1
#define REG_ACC_CONFIG       0x08
#define REG_MAG_CONFIG       0x09
#define REG_GYR_CONFIG_0     0x0A
#define REG_GYR_CONFIG_1     0x0B
#define REG_ACC_SLEEP_CONFIG 0x0C
#define REG_GYR_SLEEP_CONFIG 0x0D
#define REG_INT_MSK          0x0F
#define REG_INT_EN           0x10
#define REG_ACC_AM_THRES     0x11
#define REG_ACC_INT_SETTINGS 0x12
#define REG_ACC_HG_DURATION  0x13
#define REG_ACC_HG_THRES     0x14
#define REG_ACC_NM_THRES     0x15
#define REG_ACC_NM_SET       0x16
#define REG_GYR_INT_SETTINGS 0x17
#define REG_GYR_HR_X_SET     0x18
#define REG_GYR_DUR_X        0x19
#define REG_GYR_HR_Y_SET     0x1A
#define REG_GYR_DUR_Y        0x1B
#define REG_GYR_HR_Z_SET     0x1C
#define REG_GYR_DUR_Z        0x1D
#define REG_GYR_AM_THRES     0x1E
#define REG_GYR_AM_SET       0x1F
#define REG_UNIQUE_ID_0      0x50
#define REG_UNIQUE_ID_1      0x51
#define REG_UNIQUE_ID_2      0x52
#define REG_UNIQUE_ID_3      0x53
#define REG_UNIQUE_ID_4      0x54
#define REG_UNIQUE_ID_5      0x55
#define REG_UNIQUE_ID_6      0x56
#define REG_UNIQUE_ID_7      0x57
#define REG_UNIQUE_ID_8      0x58
#define REG_UNIQUE_ID_9      0x59
#define REG_UNIQUE_ID_A      0x5A
#define REG_UNIQUE_ID_B      0x5B
#define REG_UNIQUE_ID_C      0x5C
#define REG_UNIQUE_ID_D      0x5D
#define REG_UNIQUE_ID_E      0x5E
#define REG_UNIQUE_ID_F      0x5F

typedef struct {
	int16_t acc_x; // 1m/s^2 = 100 LSB
	int16_t acc_y;
	int16_t acc_z;
	int16_t mag_x; // 1µT = 16 LSB
	int16_t mag_y;
	int16_t mag_z;
	int16_t gyr_x; // 1dps (degree-per-second) = 16 LSB
	int16_t gyr_y;
	int16_t gyr_z;
	int16_t eul_heading; // 1° = 16 LSB
	int16_t eul_roll;
	int16_t eul_pitch;
	uint16_t qua_w; // 1 Quaternion = 2^14 LSB
	uint16_t qua_x;
	uint16_t qua_y;
	uint16_t qua_z;
	int16_t lia_x; // 1m/s^2 = 100 LSB
	int16_t lia_y;
	int16_t lia_z;
	int16_t grv_x; // 1m/s^2 = 100 LSB
	int16_t grv_y;
	int16_t grv_z;
	int8_t temperature; // 1°C = 1 LSB
	uint8_t calibration_status;
} __attribute__((packed)) SensorData;

#define IMU_CALIBRATION_PASSWORD 0xDEADBEEF
#define IMU_CALIBRATION_LENGTH (sizeof(IMUCalibration) - sizeof(uint32_t))
#define IMU_CALIBRATION_ADDRESS (END_OF_BRICKLET_MEMORY - 0x400)
typedef struct {
	int16_t acc_offset[3];
	int16_t mag_offset[3];
	int16_t gyr_offset[3];
	int16_t acc_radius;
	int16_t mag_radius;
	uint32_t password;
} __attribute__((packed)) IMUCalibration;

typedef struct {
	const int16_t acc_offset[3];
	const int16_t mag_offset[3];
	const int16_t gyr_offset[3];
	const int16_t acc_radius;
	const int16_t mag_radius;
	const uint32_t password;
} __attribute__((packed)) IMUCalibrationConst;

void tick_task(const uint8_t tick_type);
void make_period_callback(const uint8_t type);

void update_sensor_data(void);

void imu_blinkenlights(void);
void imu_leds_on(const bool on);
void bmo_read_register(const uint8_t reg, uint8_t *data, const uint8_t length);
void bmo_read_registers(const uint8_t reg, uint8_t *data, const uint8_t length);
void bmo_read_registers_dma(const uint8_t reg, uint8_t *data, const uint8_t length, void *callback);
void bmo_write_registers(const uint8_t reg, const uint8_t *data, const uint8_t length);

bool read_calibration_from_bno055_and_save_to_flash(void);
bool read_calibration_from_flash_and_save_to_bno055(void);
void imu_update_sensor_fusion_mode(void);
void imu_update_sensor_configuration(void);
void update_sensor_data_save(void);
void imu_init(void);

#endif
