Tinkerforge/imu-v2-brick/(commit log)

2015-03-26 add hardware files for imu v2
    [bricklets.sch, imu.kicad_pcb, imu.sch, leds.sch, powersupply.sch, sensor.sch, stack.sch]
2015-03-26 add schematic
2015-03-31 increase signal to border distance
    [imu.kicad_pcb]
2015-04-01 route signals with more distance to border
    [imu.kicad_pcb]
2015-04-08 Add first stub implementation of IMU Brick 2.0
    Currently mostly copied from IMU Brick 1.0
2015-04-08 Add sensor data unit information
2015-04-09 Implement API for new IMU 2.0 features
2015-04-14 Remove configuration, add calibration
2015-04-14 Put IMU in in config mode before ext clk enable
2015-04-23 change footprint of bno055 crystal
    [bricklets.sch, imu.kicad_pcb, imu.sch, leds.sch, powersupply.sch, sensor.sch, stack.sch]
2015-05-07 fix tvs diode orientation, fix component texts
    [bricklets.sch, imu.kicad_pcb, imu.sch, leds.sch, powersupply.sch, sensor.sch, stack.sch]
2015-05-07 change some routing, change drill positions, change silkscreen
    [imu.kicad_pcb]
2015-06-22 Fix wrong order, add comment
    [communication.h, imu.c]
2015-08-07 Use full device class name in Python examples
2015-08-19 Read the IMU data in 10 different stages
2015-08-19 Remove double increment of sensor counter
2015-09-17 javascript: Print calibration status as bitmask
2015-10-26 Fix wrong order of callbacks
    [config.h, imu.c, imu.h]
2015-10-26 Fix wrong FID order too
    [communication.h]
2016-01-13 Saving of calibration currently only on sam3s
    We added support for the sam4s processor family to bricklib, saving the
    calibration to the flash is currently not possible with the old code. We just
    remove it for sam4s for now (we will fix it if there actually is a IMU Brick
    with the sam4s)
    [imu.c]
2016-02-09 Fix possible data corruption if getters are called with high frequency
    [config.h, imu.c]
2016-02-25 Use DMA for I2C communication with BNO055
    This allows for better SPI stack communication throughput, since
    we don't have to disable the interrupts for the whole communication
2016-05-18 c: Add missing device destroy call
2016-07-25 fix diode symbols
    [bricklets.sch, imu.kicad_pcb, imu.sch, leds.sch, powersupply.sch, sensor.sch, stack.sch]
2016-12-05 dd ringbuffer and system timer utility as well as co_mcu support files to Makefile (all added through bricklib)
2017-01-27 Add support for fusion mode and sensor configuration
2017-02-03 Add support for fusion mode without magnetometer
2017-03-16 Move I2C mutex handling outside of interrupt.
    This fixes a race condition with the Accelerometer Bricklet (and potentially other Bricklets that use I2C),
    [config.h, imu.c, imu.h]
2017-06-02 Update footprints for 3d
    [bricklets.sch, imu.sch, leds.sch, powersupply.sch, sensor.sch, stack.sch]
2017-06-02 Add some 3d components
    [imu.kicad_pcb]
2017-06-02 Fix footprints
    [bricklets.sch, sensor.sch]
2017-06-02 Add all 3d information
    [bricklets.sch, imu.kicad_pcb, imu.sch, leds.sch, powersupply.sch, sensor.sch, stack.sch]
2017-06-02 Add 3D model for IMUv2 Brick
2017-06-30 3d: New version of tactile switches
    [imu.kicad_pcb]
2018-01-11 Increase version number (message duplication bug fix through bricklib)
    [config.h]
2018-02-20 Cleanup KiCad libraries config
    Ensure LibDir=kicad-libraries and LibName1=tinkerforge.
    Remove special library.
2018-04-27 Remove unnecessary return
    This actually broke the callback period timing...
    [imu.c]
2018-04-27 Add calibration support for SAM4 microcontroller
2018-07-20 Add support for fusion mode without fast magnetometer calibration
2018-07-25 Add new 3d model
    [imu.kicad_pcb]
2018-12-14 go: Fix printf parameters.
2019-05-15 add the imu 3d model with silkscreen
    [imu.FCStd]
2020-02-20 v3 prototype initial push
    [bricklets.sch, imu.kicad_pcb, imu.sch, leds.sch, powersupply.sch, sensor.sch, stack.sch]
2021-03-23 Fix temperature callback response size.
    [imu.c]
2021-10-25 Update KiCad link
    https://www.kicad.org/blog/2021/10/Avoid-links-to-former-kicad-domain/
