Tinkerforge/imu-v2-brick/(notices)

Notices in the files:
hardware/V3/stack.sch:
Copyright (©) 2020, T.Schneidermann
hardware/V3/imu.sch:
Copyright Tinkerforge GmbH 2020.
